PUT-Motorsport/PUTM_EV_REARBOX_2023/hardware/rearbox/rearbox.kicad_pcb

## KiCad design hardware/rearbox/rearbox.kicad_pcb (2026-01-03)

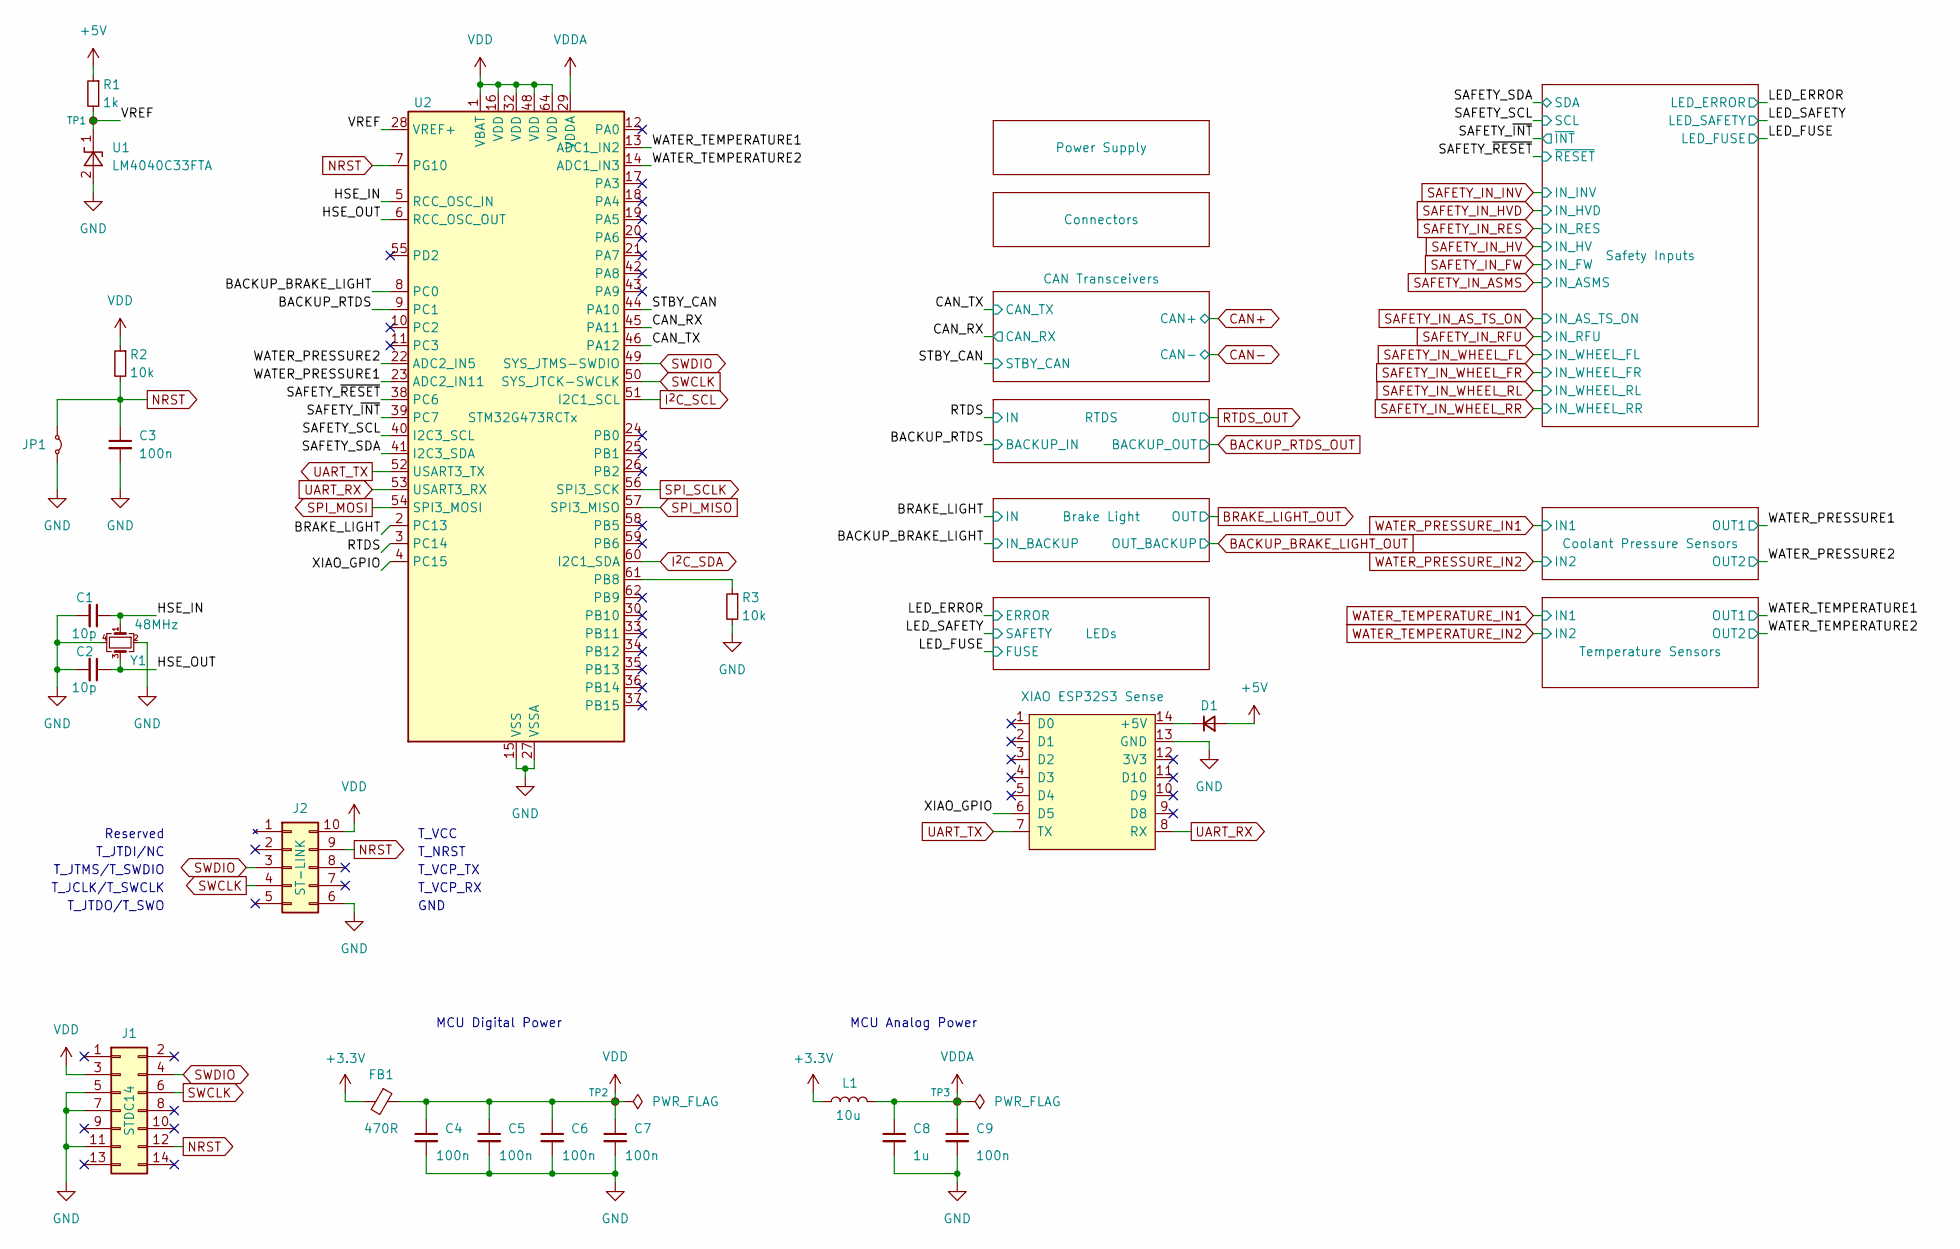
[picture p1: schematic rearbox.kicad_sch]

Parts:
C1, C2: 10p; C_0603_1608Metric
C3, C4, C5, C6, C7, C9: 100n; C_0603_1608Metric
C8: 1u; C_0603_1608Metric
D1: NSVRB751V40T1G; D_SOD-323_HandSoldering; Mouser Part Number 863-NSVRB751V40T1G
FB1: 470R; L_0603_1608Metric
J1: STDC14; PinHeader_2x07_P1.27mm_Vertical_SMD
J2: ST-LINK; STLINK-V3MINIE
J5: XIAO ESP32S3 Sense; XIAO-ESP32S3-DIP
JP1: Jumper_2_Small_Bridged; SolderJumper-2_P1.3mm_Open_TrianglePad1.0x1.5mm
L1: 10u; L_0603_1608Metric
R1: 1k; R_0603_1608Metric
R2, R3: 10k; R_0603_1608Metric
TP1, TP2, TP3: TestPoint_Small; TestPoint_Pad_D1.0mm
U1: LM4040C33FTA; SOT-23
U2: STM32G473RCTx; LQFP-64_10x10mm_P0.5mm
Y1: 48MHz; Crystal_SMD_Abracon_ABM8G-4Pin_3.2x2.5mm

Connections:
+3.3V: FB1.2, L1.1; also elsewhere on the board
+5V: D1.2 (A), R1.1; also elsewhere on the board
/BACKUP_BRAKE_LIGHT: U2.8 (PC0); also elsewhere on the board
/BACKUP_RTDS: U2.9 (PC1); also elsewhere on the board
/BRAKE_LIGHT: U2.2 (PC13); also elsewhere on the board
/CAN_RX: U2.45 (PA11); also elsewhere on the board
/CAN_TX: U2.46 (PA12); also elsewhere on the board
/HSE_IN: C1.1, U2.5 (RCC_OSC_IN), Y1.1
/HSE_OUT: C2.1, U2.6 (RCC_OSC_OUT), Y1.3
/RTDS: U2.3 (PC14); also elsewhere on the board
/SAFETY_SCL: U2.40 (I2C3_SCL); also elsewhere on the board
/SAFETY_SDA: U2.41 (I2C3_SDA); also elsewhere on the board
/SAFETY_~INT: U2.39 (PC7); also elsewhere on the board
/SAFETY_~RESET: U2.38 (PC6); also elsewhere on the board
/STBY_CAN: U2.44 (PA10); also elsewhere on the board
/VREF: R1.2, TP1.1, U1.1 (K), U2.28 (VREF+)
/WATER_PRESSURE1: U2.23 (ADC2_IN11); also elsewhere on the board
/WATER_PRESSURE2: U2.22 (ADC2_IN5); also elsewhere on the board
/WATER_TEMPERATURE1: U2.13 (ADC1_IN2); also elsewhere on the board
/WATER_TEMPERATURE2: U2.14 (ADC1_IN3); also elsewhere on the board
/XIAO_GPIO: J5.6 (D5), U2.4 (PC15)
GND: C1.2, C2.2, C3.2, C4.2, C5.2, C6.2, C7.2, C8.2, C9.2, J1.5, J1.7, J1.11, J2.6 (GND), J5.13 (GND), JP1.2 (B), R3.2, U1.2 (A), U2.15 (VSS), U2.27 (VSSA), U2.31 (VSS), U2.47 (VSS), U2.63 (VSS), Y1.2, Y1.4; also elsewhere on the board
I^{2}C_SCL: U2.51 (I2C1_SCL); also elsewhere on the board
I^{2}C_SDA: U2.60 (I2C1_SDA); also elsewhere on the board
NRST: C3.1, J1.12, J2.9 (T_NRST), JP1.1 (A), R2.2, U2.7 (PG10)
unnamed: D1.1 (K), J5.14 (+5V)
unnamed: R3.1, U2.61 (PB8)
SPI_MISO: U2.57 (SPI3_MISO); also elsewhere on the board
SPI_MOSI: U2.54 (SPI3_MOSI); also elsewhere on the board
SPI_SCLK: U2.56 (SPI3_SCK); also elsewhere on the board
SWCLK: J1.6, J2.4 (T_JCLK/T_SWCLK), U2.50 (SYS_JTCK-SWCLK)
SWDIO: J1.4, J2.3 (T_JTMS/T_SWDIO), U2.49 (SYS_JTMS-SWDIO)
UART_RX: J5.8 (RX), U2.53 (USART3_RX); also elsewhere on the board
UART_TX: J5.7 (TX), U2.52 (USART3_TX); also elsewhere on the board
VDD: C4.1, C5.1, C6.1, C7.1, FB1.1, J1.3, J2.10 (T_VCC), R2.1, TP2.1, U2.1 (VBAT), U2.16 (VDD), U2.32 (VDD), U2.48 (VDD), U2.64 (VDD)
VDDA: C8.1, C9.1, L1.2, TP3.1, U2.29 (VDDA)

Notes on the sheet:
T_JCLK/T_SWCLK
T_JTMS/T_SWDIO
MCU Analog Power
T_JTDI/NC
T_VCC
T_JTDO/T_SWO
T_NRST
Reserved
T_VCP_RX
T_VCP_TX
GND
MCU Digital Power

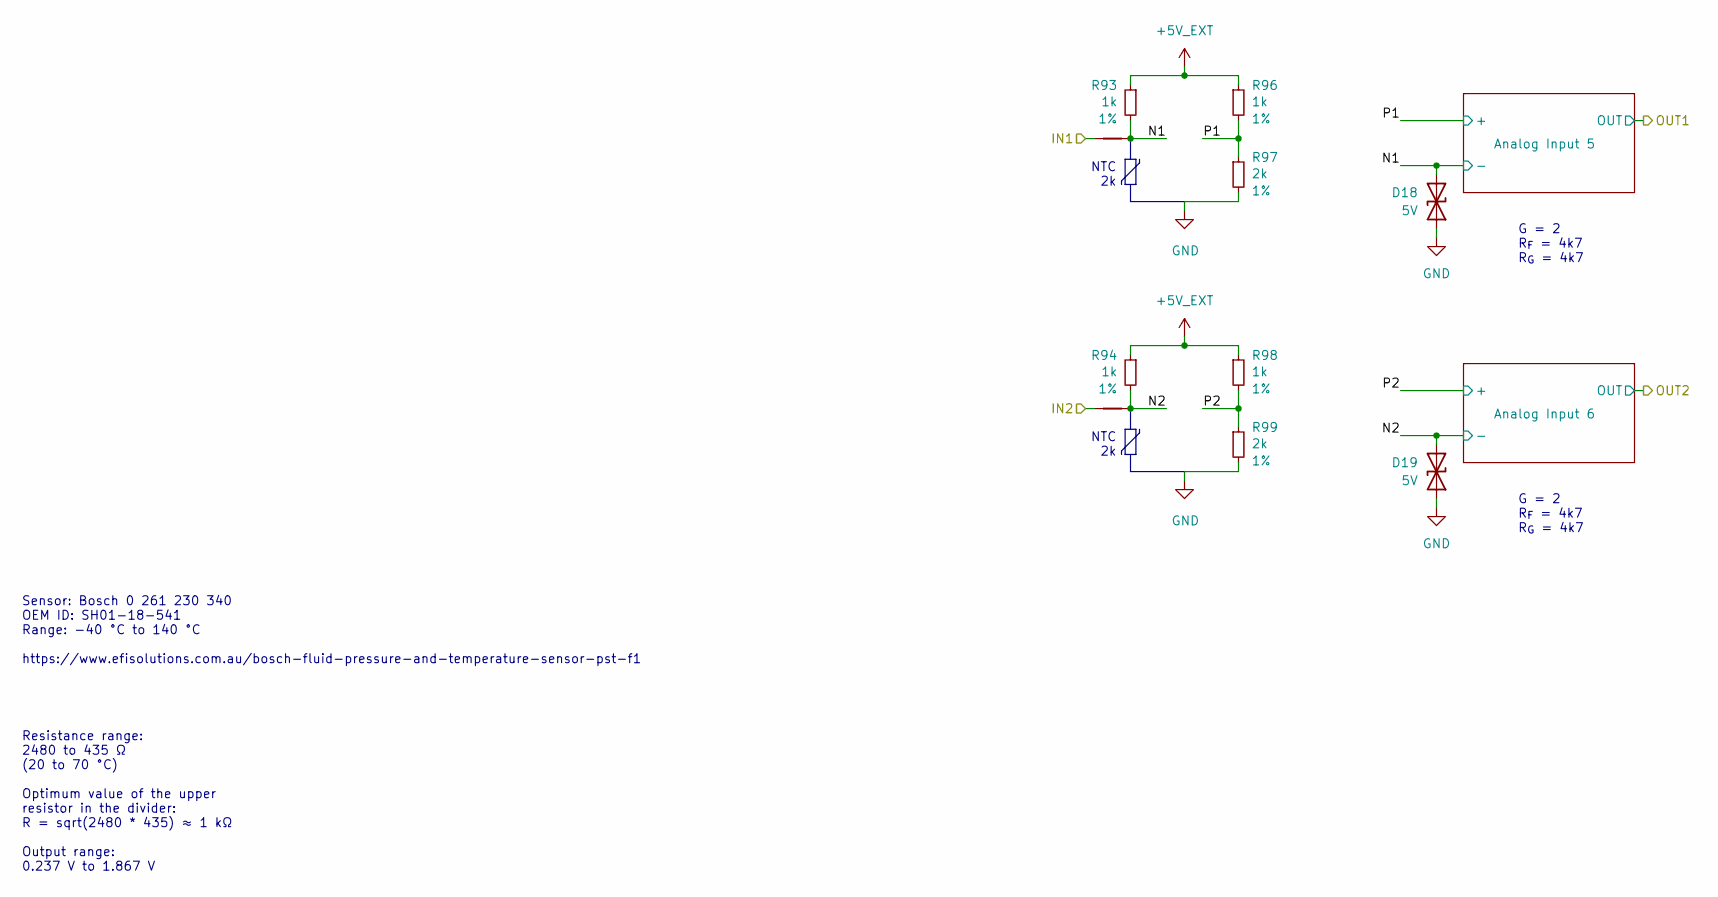
[picture p2: schematic temperature_sensors.kicad_sch, Temperature Sensors]

Parts:
D18, D19: 5V; D_SOD-523
NT1, NT2: NetTie_2; NetTie-2_SMD_Pad0.2mm
R93, R94, R96, R98: 1k; R_0603_1608Metric; Tolerance 1%
R97, R99: 2k; R_0603_1608Metric; Tolerance 1%

Connections:
+5V_EXT: R93.1, R94.1, R96.1, R98.1; also elsewhere on the board
/Temperature Sensors/N1: D18.2 (A2), NT1.2, R93.2; also elsewhere on the board
/Temperature Sensors/N2: D19.2 (A2), NT2.2, R94.2; also elsewhere on the board
/Temperature Sensors/P1: R96.2, R97.1; also elsewhere on the board
/Temperature Sensors/P2: R98.2, R99.1; also elsewhere on the board
GND: D18.1 (A1), D19.1 (A1), R97.2, R99.2; also elsewhere on the board
WATER_TEMPERATURE_IN1: NT1.1; also elsewhere on the board
WATER_TEMPERATURE_IN2: NT2.1; also elsewhere on the board

Notes on the sheet:
G = 2 R_{F} = 4k7 R_{G} = 4k7
NTC 2k
Resistance range: 2480 to 435 Ω (20 to 70 °C) Optimum value of the upper resistor in the divider: R = sqrt(2480 * 435) ≈ 1 kΩ Output range: 0.237 V to 1.867 V
Sensor: Bosch 0 261 230 340 OEM ID: SH01-18-541 Range: -40 °C to 140 °C https://www.efisolutions.com.au/bosch-fluid-pressure-and-temperature-sensor-pst-f1

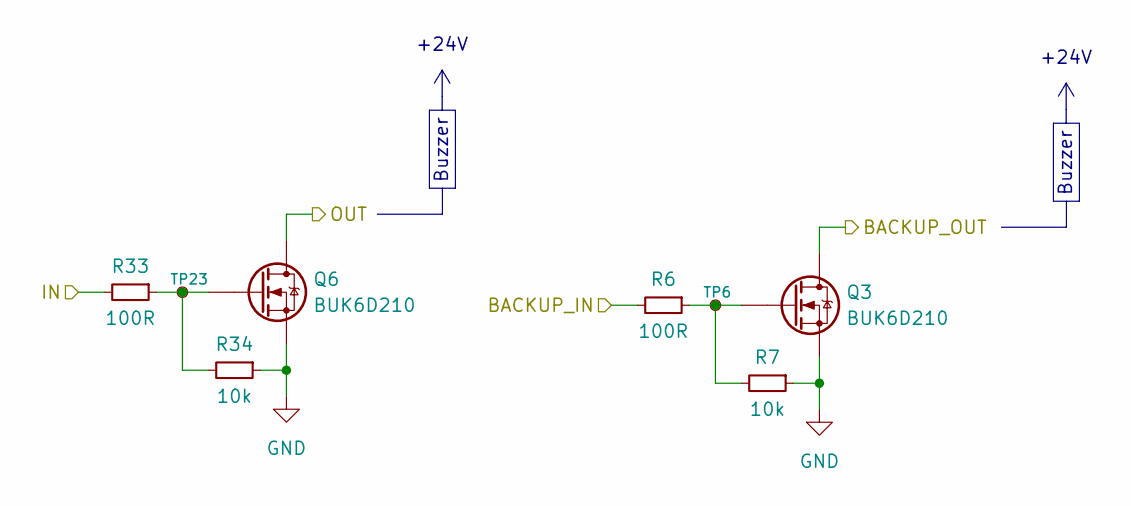
[picture p3: schematic ready_to_drive_sound.kicad_sch, Ready to Drive Sound]

Parts:
Q3, Q6: BUK6D210; Diodes_UDFN2020-6_Type-F
R6, R33: 100R; R_0603_1608Metric
R7, R34: 10k; R_0603_1608Metric
TP6, TP23: TestPoint_Small; TestPoint_Pad_D1.0mm

Connections:
/BACKUP_RTDS: R6.2; also elsewhere on the board
/RTDS: R33.2; also elsewhere on the board
BACKUP_RTDS_OUT: Q3.1 (D), Q3.2 (D), Q3.5 (D), Q3.6 (D), Q3.7 (D); also elsewhere on the board
GND: Q3.4 (S), Q3.8 (S), Q6.4 (S), Q6.8 (S), R7.1, R34.1; also elsewhere on the board
unnamed: Q3.3 (G), R6.1, R7.2, TP6.1
unnamed: Q6.3 (G), R33.1, R34.2, TP23.1
RTDS_OUT: Q6.1 (D), Q6.2 (D), Q6.5 (D), Q6.6 (D), Q6.7 (D); also elsewhere on the board

Notes on the sheet:
+24V
Buzzer

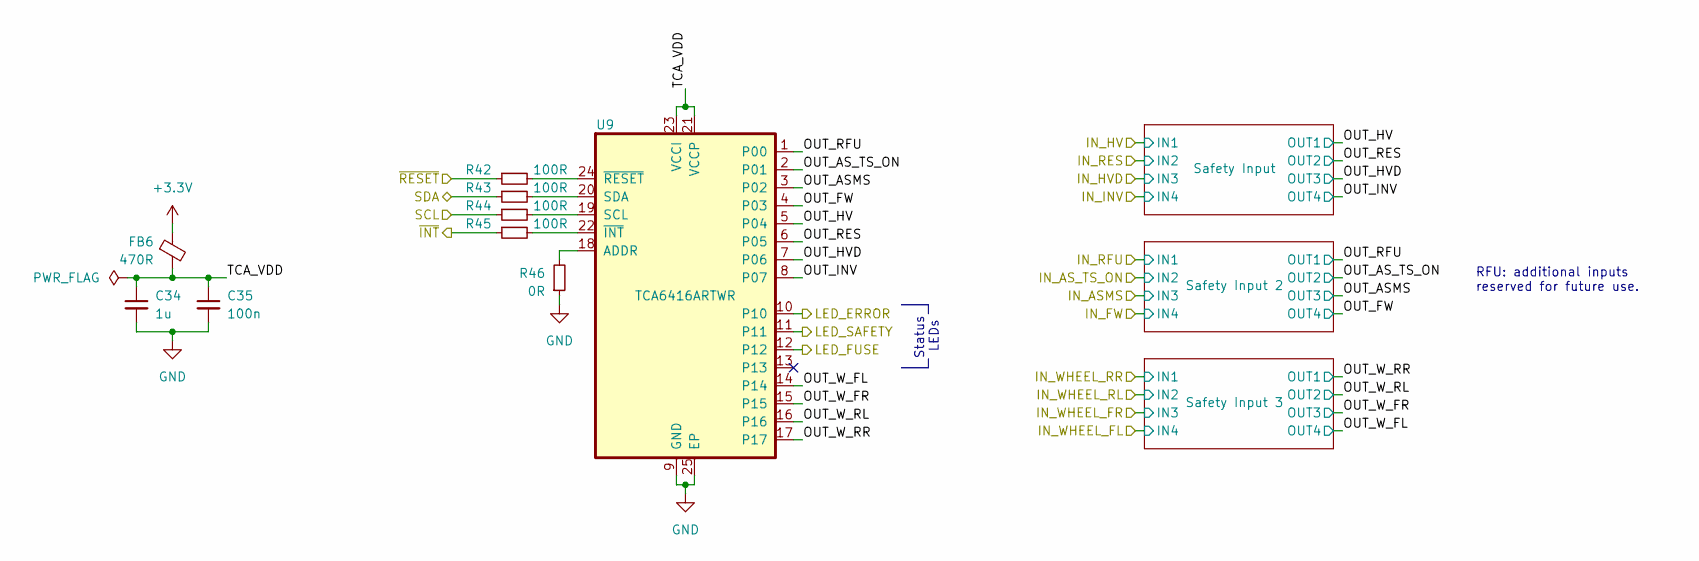
[picture p4: schematic safety_inputs.kicad_sch, Safety Inputs]

Parts:
C34: 1u; C_0603_1608Metric
C35: 100n; C_0603_1608Metric
FB6: 470R; L_0603_1608Metric
R42, R43, R44, R45: 100R; R_0603_1608Metric
R46: 0R; R_0603_1608Metric
U9: TCA6416ARTWR; QFN50P400X400X80-25N

Connections:
+3.3V: FB6.1; also elsewhere on the board
/LED_ERROR: U9.10; also elsewhere on the board
/LED_FUSE: U9.12; also elsewhere on the board
/LED_SAFETY: U9.11; also elsewhere on the board
/SAFETY_SCL: R44.1; also elsewhere on the board
/SAFETY_SDA: R43.1; also elsewhere on the board
/SAFETY_~INT: R45.1; also elsewhere on the board
/SAFETY_~RESET: R42.1; also elsewhere on the board
/Safety Inputs/OUT_ASMS: U9.3 (P02); also elsewhere on the board
/Safety Inputs/OUT_AS_TS_ON: U9.2 (P01); also elsewhere on the board
/Safety Inputs/OUT_FW: U9.4 (P03); also elsewhere on the board
/Safety Inputs/OUT_HV: U9.5 (P04); also elsewhere on the board
/Safety Inputs/OUT_HVD: U9.7 (P06); also elsewhere on the board
/Safety Inputs/OUT_INV: U9.8 (P07); also elsewhere on the board
/Safety Inputs/OUT_RES: U9.6 (P05); also elsewhere on the board
/Safety Inputs/OUT_RFU: U9.1 (P00); also elsewhere on the board
/Safety Inputs/OUT_W_FL: U9.14; also elsewhere on the board
/Safety Inputs/OUT_W_FR: U9.15; also elsewhere on the board
/Safety Inputs/OUT_W_RL: U9.16; also elsewhere on the board
/Safety Inputs/OUT_W_RR: U9.17; also elsewhere on the board
/Safety Inputs/TCA_VDD: C34.1, C35.1, FB6.2, U9.21 (VCCP), U9.23 (VCCI)
GND: C34.2, C35.2, R46.1, U9.9 (GND), U9.25 (EP); also elsewhere on the board
unnamed: R46.2, U9.18 (ADDR)
unnamed: R44.2, U9.19 (SCL)
unnamed: R43.2, U9.20 (SDA)
unnamed: R45.2, U9.22 (~INT)
unnamed: R42.2, U9.24 (~RESET)

Notes on the sheet:
Status LEDs
RFU: additional inputs reserved for future use.

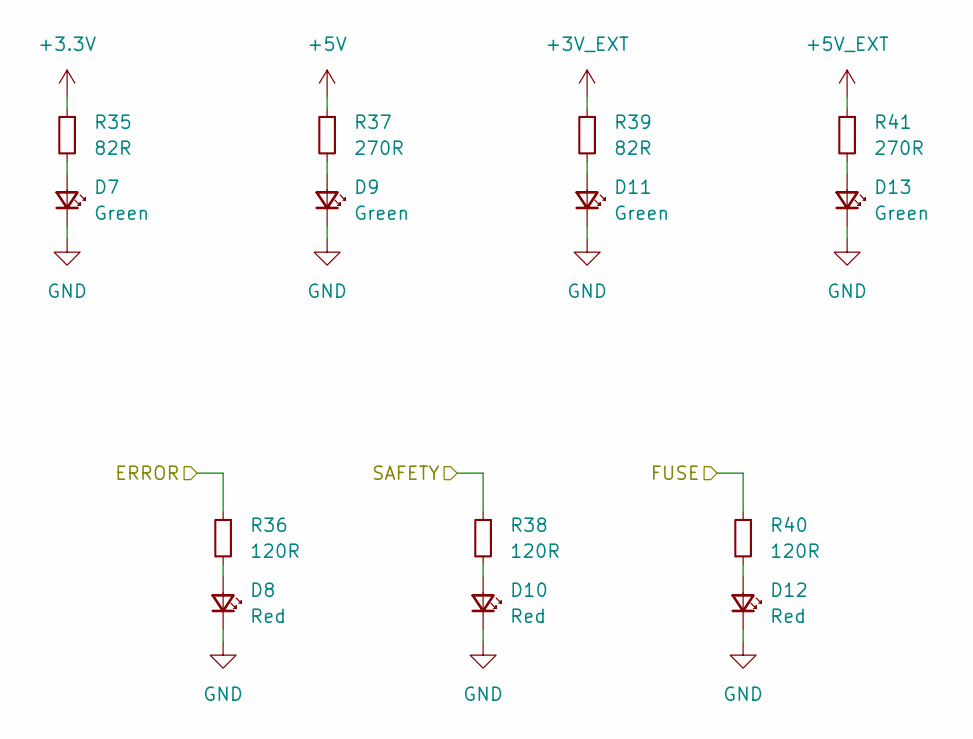
[picture p5: schematic leds.kicad_sch]

Parts:
D7, D9, D11, D13: Green; LED_0603_1608Metric
D8, D10, D12: Red; LED_0603_1608Metric
R35, R39: 82R; R_0603_1608Metric
R36, R38, R40: 120R; R_0603_1608Metric
R37, R41: 270R; R_0603_1608Metric

Connections:
+3.3V: R35.1; also elsewhere on the board
+3V_EXT: R39.1; also elsewhere on the board
+5V: R37.1; also elsewhere on the board
+5V_EXT: R41.1; also elsewhere on the board
/LED_ERROR: R36.1; also elsewhere on the board
/LED_FUSE: R40.1; also elsewhere on the board
/LED_SAFETY: R38.1; also elsewhere on the board
GND: D7.1 (K), D8.1 (K), D9.1 (K), D10.1 (K), D11.1 (K), D12.1 (K), D13.1 (K); also elsewhere on the board
unnamed: D7.2 (A), R35.2
unnamed: D8.2 (A), R36.2
unnamed: D9.2 (A), R37.2
unnamed: D10.2 (A), R38.2
unnamed: D11.2 (A), R39.2
unnamed: D12.2 (A), R40.2
unnamed: D13.2 (A), R41.2

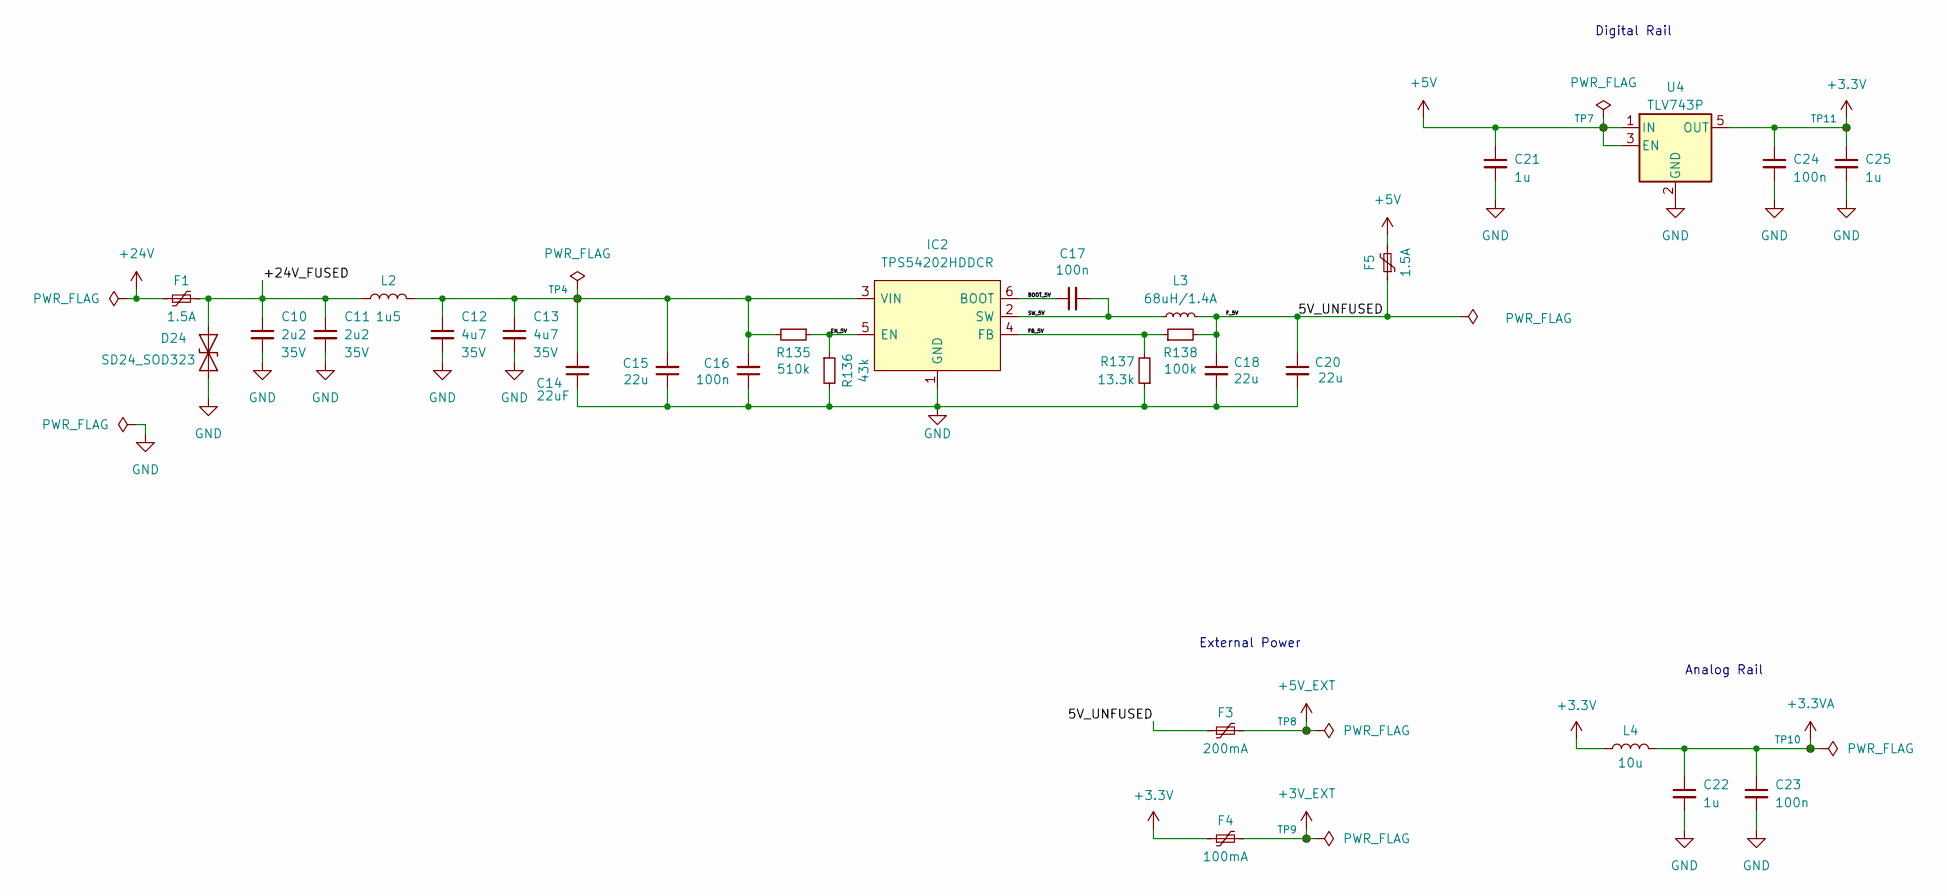
[picture p6: schematic power_supply.kicad_sch, Power Supply]

Parts:
C10, C11: 2u2; C_0805_2012Metric; Rated Voltage 35V
C12, C13: 4u7; C_0805_2012Metric; Rated Voltage 35V
C14: 22uF; C_0805_2012Metric; Manufacturer_Part_Number CL21A107MQYNNWE; Mouser Part Number 810-C2012X5R1V226MAC
C15, C18, C20: 22u; C_0805_2012Metric; Manufacturer_Part_Number CL21A107MQYNNWE; Mouser Part Number 810-C2012X5R1V226MAC
C16, C17: 100n; C_0603_1608Metric; Manufacturer_Part_Number C0603C104J3RACTU; Mouser Part Number --
C21, C22, C25: 1u; C_0603_1608Metric
C23, C24: 100n; C_0603_1608Metric
D24: SD24_SOD323; D_SOD-323
F1, F5: 1.5A; Fuse_1812_4532Metric
F3: 200mA; Fuse_1812_4532Metric
F4: 100mA; Fuse_1812_4532Metric
IC2: TPS54202HDDCR; SOT-23-6; Mouser Part Number 595-TPS54202HDDCR
L2: 1u5; L_Abracon_ASPI-4030S
L3: 68uH/1.4A; L_TDK_VLS6045EX_VLS6045AF; Mouser Part Number 810-VLS6045EX-680M
L4: 10u; L_0603_1608Metric
R135: 510k; R_0603_1608Metric; Manufacturer_Part_Number RT0603DRD07510KL; Mouser Part Number 603-RT0603DRD07510KL
R136: 43k; R_0603_1608Metric; Manufacturer_Part_Number RT0603DRD07510KL; Mouser Part Number 603-RT0603DRD07510KL
R137: 13.3k; R_0603_1608Metric; Manufacturer_Part_Number RT0603DRE0713K3L; Mouser Part Number 603-RT0603DRE0713K3L
R138: 100k; R_0603_1608Metric; Manufacturer_Part_Number RT0603DRE07100KL; Mouser Part Number --
TP4, TP7, TP8, TP9, TP10, TP11: TestPoint_Small; TestPoint_Pad_D1.0mm
U4: TLV743P; SOT-23-5

Connections:
+3.3V: C24.1, C25.1, F4.1, L4.1, TP11.1, U4.5 (OUT); also elsewhere on the board
+3.3VA: C22.1, C23.1, L4.2, TP10.1; also elsewhere on the board
+3V_EXT: F4.2, TP9.1; also elsewhere on the board
+5V: C21.1, F5.2, TP7.1, U4.1 (IN), U4.3 (EN); also elsewhere on the board
+5V_EXT: F3.2, TP8.1; also elsewhere on the board
+24V: F1.1; also elsewhere on the board
/Power Supply/5V_UNFUSED: C18.1, C20.1, F3.1, F5.1, L3.2, R138.2
/Power Supply/+24V_FUSED: C10.1, C11.1, D24.2 (A2), F1.2, L2.1
/Power Supply/BOOT_5V: C17.1, IC2.6 (BOOT)
/Power Supply/EN_5V: IC2.5 (EN), R135.1, R136.1
/Power Supply/FB_5V: IC2.4 (FB), R137.2, R138.1
/Power Supply/SW_5V: C17.2, IC2.2 (SW), L3.1
GND: C10.2, C11.2, C12.2, C13.2, C14.1, C15.1, C16.1, C18.2, C20.2, C21.2, C22.2, C23.2, C24.2, C25.2, D24.1 (A1), IC2.1 (GND), R136.2, R137.1, U4.2 (GND); also elsewhere on the board
unnamed: C12.1, C13.1, C14.2, C15.2, C16.2, IC2.3 (VIN), L2.2, R135.2, TP4.1

Notes on the sheet:
Analog Rail
Digital Rail
External Power

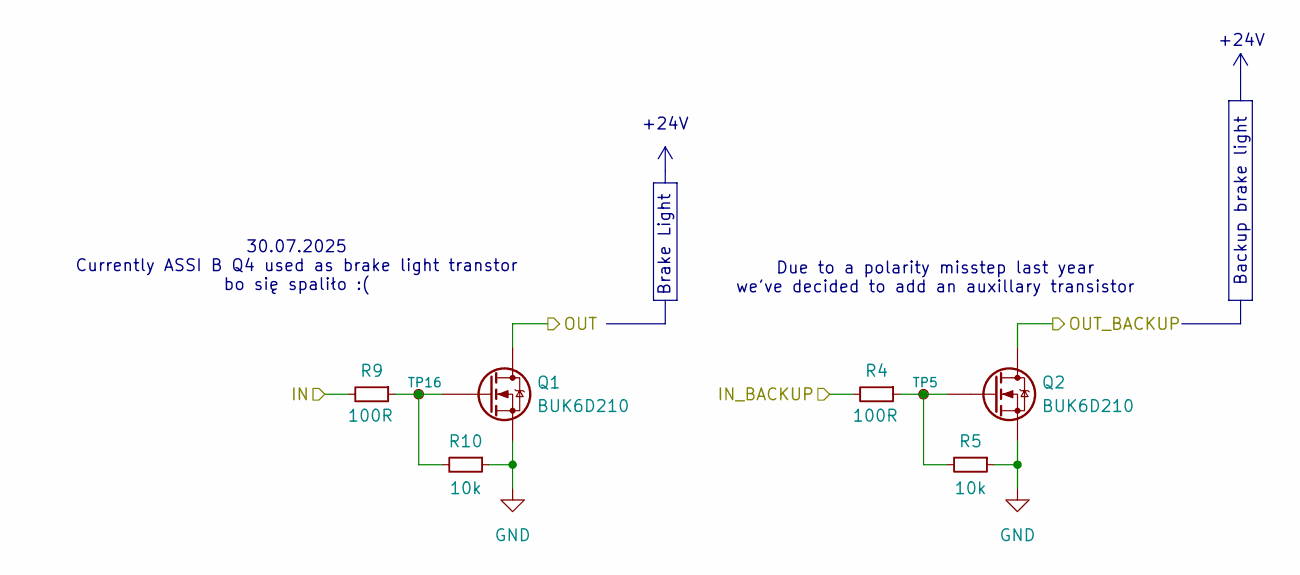
[picture p7: schematic brake_light.kicad_sch, Brake Light]

Parts:
Q1, Q2: BUK6D210; Diodes_UDFN2020-6_Type-F
R4, R9: 100R; R_0603_1608Metric
R5, R10: 10k; R_0603_1608Metric
TP5, TP16: TestPoint_Small; TestPoint_Pad_D1.0mm

Connections:
/BACKUP_BRAKE_LIGHT: R4.2; also elsewhere on the board
/BRAKE_LIGHT: R9.2; also elsewhere on the board
BACKUP_BRAKE_LIGHT_OUT: Q2.1 (D), Q2.2 (D), Q2.5 (D), Q2.6 (D), Q2.7 (D); also elsewhere on the board
BRAKE_LIGHT_OUT: Q1.1 (D), Q1.2 (D), Q1.5 (D), Q1.6 (D), Q1.7 (D); also elsewhere on the board
GND: Q1.4 (S), Q1.8 (S), Q2.4 (S), Q2.8 (S), R5.1, R10.1; also elsewhere on the board
unnamed: Q1.3 (G), R9.1, R10.2, TP16.1
unnamed: Q2.3 (G), R4.1, R5.2, TP5.1

Notes on the sheet:
30.07.2025 Currently ASSI B Q4 used as brake light transtor bo się spaliło :(
Brake Light
+24V
Due to a polarity misstep last year we've decided to add an auxillary transistor
Backup brake light

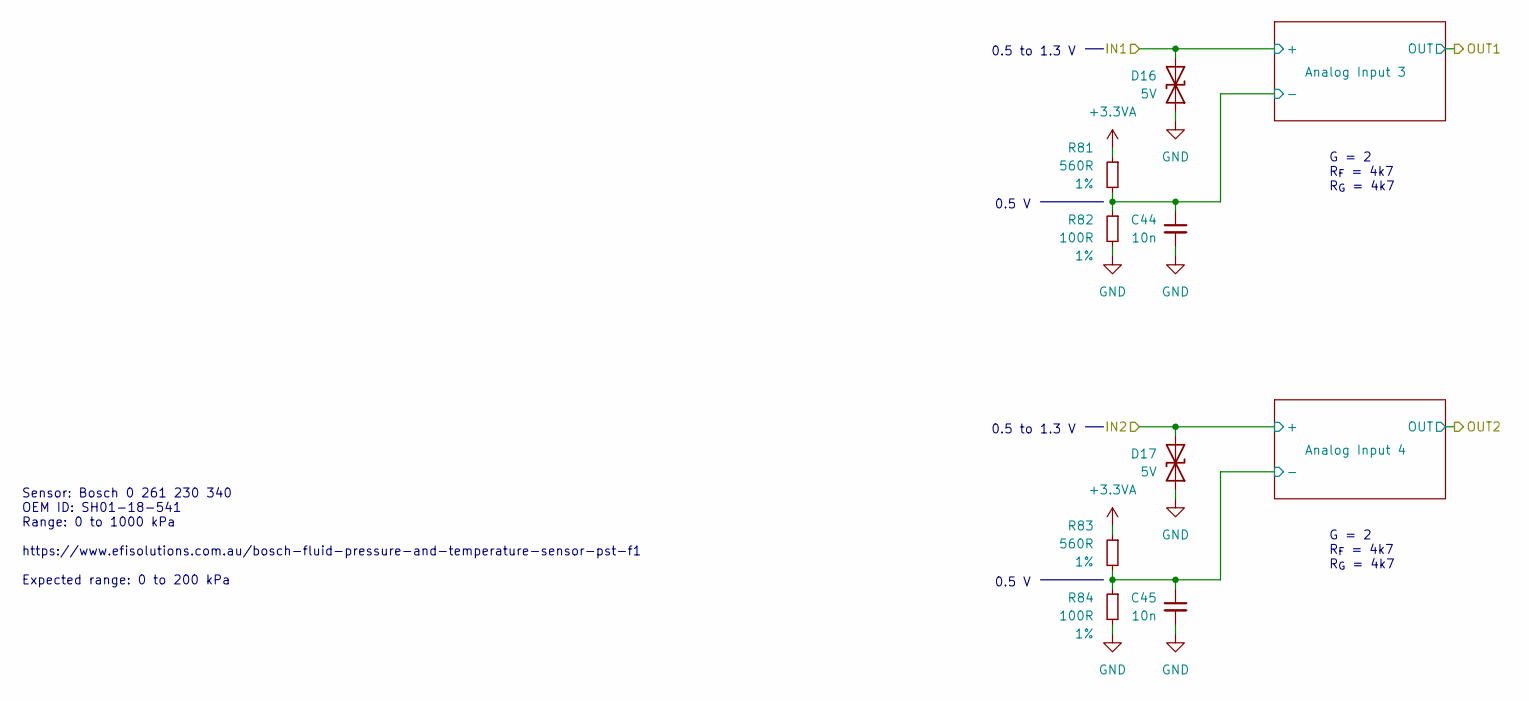
[picture p8: schematic water_pressure_sensors.kicad_sch, Water Pressure Sensors]

Parts:
C44, C45: 10n; C_0603_1608Metric
D16, D17: 5V; D_SOD-523
R81, R83: 560R; R_0603_1608Metric; Tolerance 1%
R82, R84: 100R; R_0603_1608Metric; Tolerance 1%

Connections:
+3.3VA: R81.1, R83.1; also elsewhere on the board
/Coolant Pressure Sensors/Analog Input 3/-: C44.1, R81.2, R82.1; also elsewhere on the board
/Coolant Pressure Sensors/Analog Input 4/-: C45.1, R83.2, R84.1; also elsewhere on the board
GND: C44.2, C45.2, D16.1 (A1), D17.1 (A1), R82.2, R84.2; also elsewhere on the board
WATER_PRESSURE_IN1: D16.2 (A2); also elsewhere on the board
WATER_PRESSURE_IN2: D17.2 (A2); also elsewhere on the board

Notes on the sheet:
0.5 V
0.5 to 1.3 V
G = 2 R_{F} = 4k7 R_{G} = 4k7
Sensor: Bosch 0 261 230 340 OEM ID: SH01-18-541 Range: 0 to 1000 kPa https://www.efisolutions.com.au/bosch-fluid-pressure-and-temperature-sensor-pst-f1 Expected range: 0 to 200 kPa

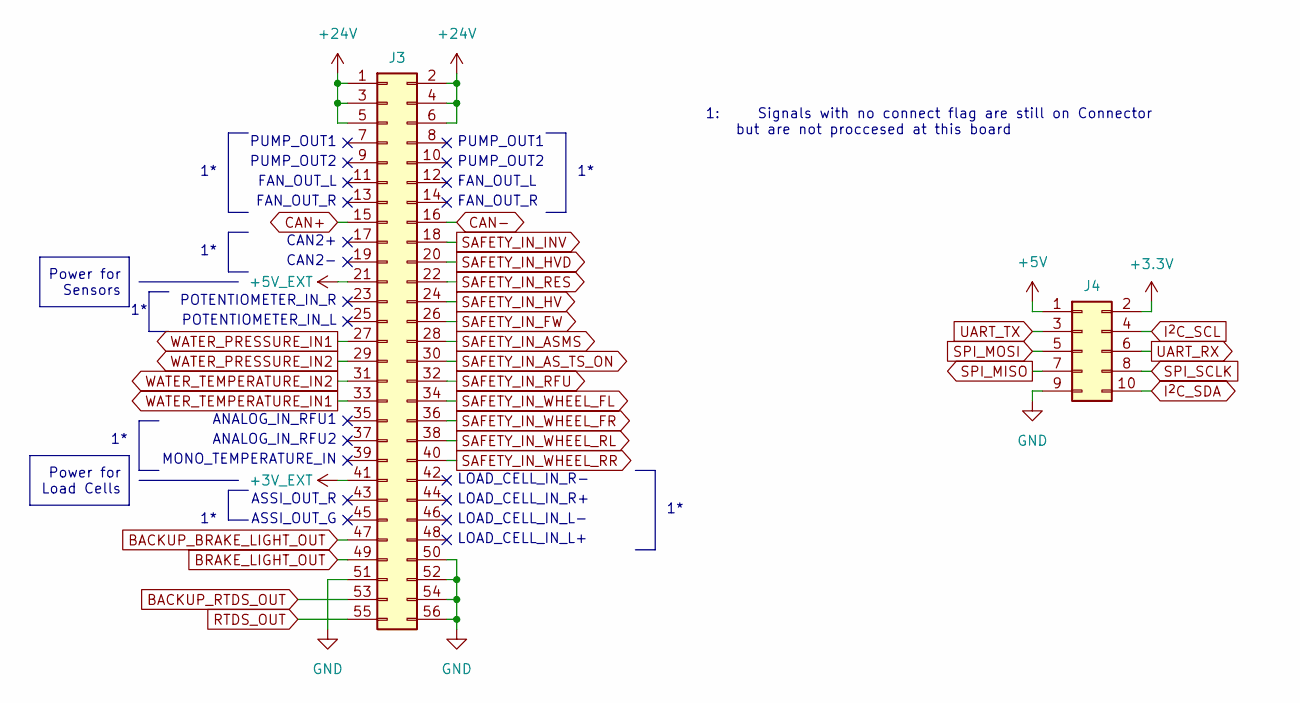
[picture p9: schematic connectors.kicad_sch]

Parts:
J3: Conn_02x28_Top_Bottom; PinHeader_2x28_P2.00mm_Horizontal
J4: Auxiliary; PinHeader_2x05_P1.27mm_Vertical_SMD

Connections:
+3.3V: J4.2; also elsewhere on the board
+3V_EXT: J3.41; also elsewhere on the board
+5V: J4.1; also elsewhere on the board
+5V_EXT: J3.21; also elsewhere on the board
+24V: J3.1, J3.2, J3.3, J3.4, J3.5, J3.6; also elsewhere on the board
BACKUP_BRAKE_LIGHT_OUT: J3.47; also elsewhere on the board
BACKUP_RTDS_OUT: J3.53; also elsewhere on the board
BRAKE_LIGHT_OUT: J3.49; also elsewhere on the board
CAN+: J3.15; also elsewhere on the board
CAN-: J3.16; also elsewhere on the board
GND: J3.50, J3.51, J3.52, J3.54, J3.56, J4.9; also elsewhere on the board
I^{2}C_SCL: J4.4; also elsewhere on the board
I^{2}C_SDA: J4.10; also elsewhere on the board
RTDS_OUT: J3.55; also elsewhere on the board
SAFETY_IN_ASMS: J3.28; also elsewhere on the board
SAFETY_IN_AS_TS_ON: J3.30; also elsewhere on the board
SAFETY_IN_FW: J3.26; also elsewhere on the board
SAFETY_IN_HV: J3.24; also elsewhere on the board
SAFETY_IN_HVD: J3.20; also elsewhere on the board
SAFETY_IN_INV: J3.18; also elsewhere on the board
SAFETY_IN_RES: J3.22; also elsewhere on the board
SAFETY_IN_RFU: J3.32; also elsewhere on the board
SAFETY_IN_WHEEL_FL: J3.34; also elsewhere on the board
SAFETY_IN_WHEEL_FR: J3.36; also elsewhere on the board
SAFETY_IN_WHEEL_RL: J3.38; also elsewhere on the board
SAFETY_IN_WHEEL_RR: J3.40; also elsewhere on the board
SPI_MISO: J4.7; also elsewhere on the board
SPI_MOSI: J4.5; also elsewhere on the board
SPI_SCLK: J4.8; also elsewhere on the board
UART_RX: J4.6; also elsewhere on the board
UART_TX: J4.3; also elsewhere on the board
WATER_PRESSURE_IN1: J3.27; also elsewhere on the board
WATER_PRESSURE_IN2: J3.29; also elsewhere on the board
WATER_TEMPERATURE_IN1: J3.33; also elsewhere on the board
WATER_TEMPERATURE_IN2: J3.31; also elsewhere on the board

Notes on the sheet:
CAN2-
PUMP_OUT2
PUMP_OUT1
ANALOG_IN_RFU2
FAN_OUT_L
LOAD_CELL_IN_R+
ASSI_OUT_G
FAN_OUT_R
POTENTIOMETER_IN_R
ANALOG_IN_RFU1
1: Signals with no connect flag are still on Connector but are not proccesed at this board
POTENTIOMETER_IN_L
LOAD_CELL_IN_L+
LOAD_CELL_IN_R-
ASSI_OUT_R
LOAD_CELL_IN_L-
CAN2+
MONO_TEMPERATURE_IN
Power for Sensors
Power for Load Cells

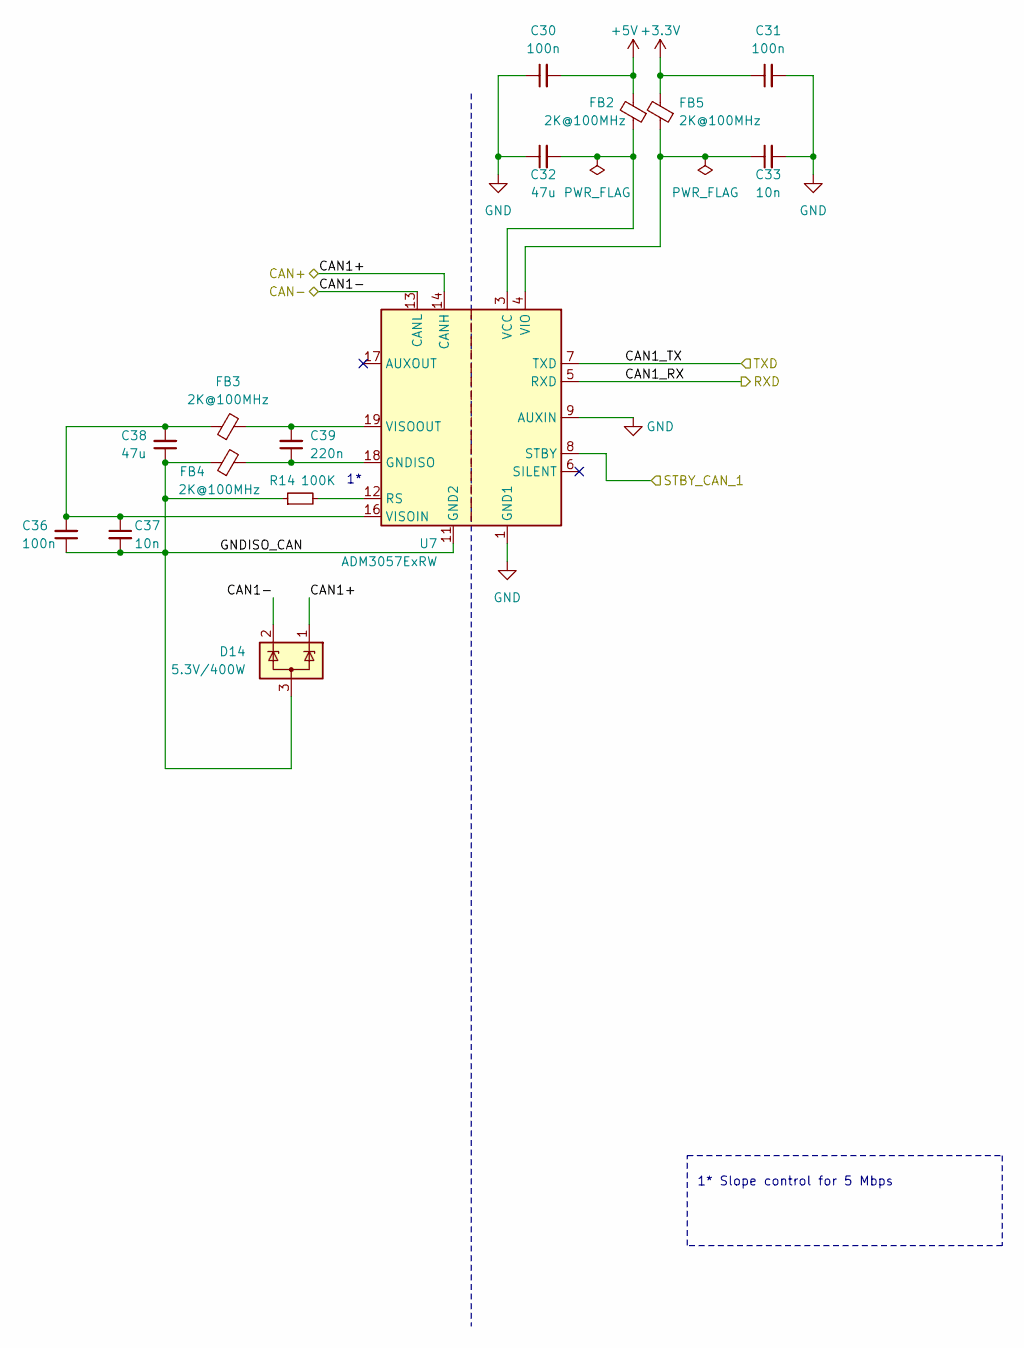
[picture p10: schematic can_transceiver.kicad_sch, CAN Transceiver]

Parts:
C30, C31, C36: 100n; C_0603_1608Metric_Pad1.08x0.95mm_HandSolder
C32, C38: 47u; C_0603_1608Metric_Pad1.08x0.95mm_HandSolder
C33, C37: 10n; C_0603_1608Metric_Pad1.08x0.95mm_HandSolder
C39: 220n; C_0603_1608Metric_Pad1.08x0.95mm_HandSolder
D14: 5.3V/400W; SOT-23-3; Mouser Part Number 511-ESDA5V3L
FB2, FB3, FB4, FB5: 2K@100MHz; L_0805_2012Metric_Pad1.05x1.20mm_HandSolder
R14: 100K; R_0603_1608Metric_Pad0.98x0.95mm_HandSolder
U7: ADM3057ExRW; SOIC-20W_7.5x12.8mm_P1.27mm

Connections:
+3.3V: C31.1, FB5.2; also elsewhere on the board
+5V: C30.2, FB2.2; also elsewhere on the board
/CAN Transceivers/CAN Transceiver/GNDISO_CAN: C36.1, C37.2, C38.1, D14.3 (A), FB4.1, R14.1, U7.11 (GND2), U7.15 (GND2)
/CAN_RX: U7.5 (RXD); also elsewhere on the board
/CAN_TX: U7.7 (TXD); also elsewhere on the board
/STBY_CAN: U7.8 (STBY); also elsewhere on the board
CAN+: D14.1 (K), U7.14 (CANH); also elsewhere on the board
CAN-: D14.2 (K), U7.13 (CANL); also elsewhere on the board
GND: C30.1, C31.2, C32.1, C33.2, U7.1 (GND1), U7.2 (GND1), U7.9 (AUXIN), U7.10 (GND1); also elsewhere on the board
unnamed: C39.1, FB4.2, U7.18 (GNDISO), U7.20 (GNDISO)
unnamed: R14.2, U7.12 (RS)
unnamed: C32.2, FB2.1, U7.3 (VCC)
unnamed: C33.1, FB5.1, U7.4 (VIO)
unnamed: C36.2, C37.1, C38.2, FB3.1, U7.16 (VISOIN)
unnamed: C39.2, FB3.2, U7.19 (VISOOUT)

Notes on the sheet:
1* Slope control for 5 Mbps
