PUT-Motorsport/PUTM_EV_REARBOX_2023/hardware/rearbox/rearbox.kicad_pcb

## KiCad design hardware/rearbox/rearbox.kicad_pcb (continued)

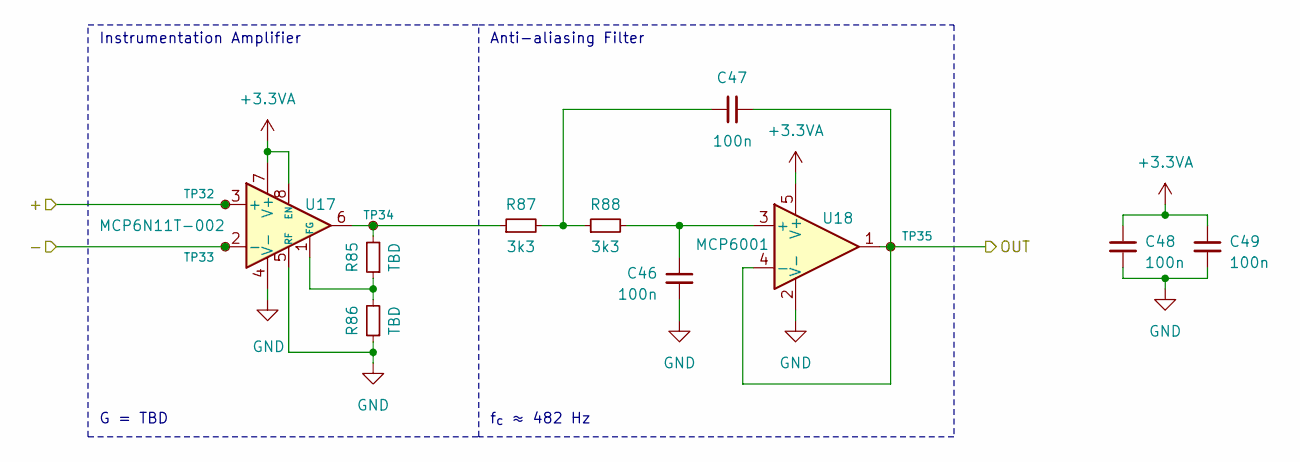
[picture p11: schematic analog_input.kicad_sch, Analog Input]

Parts:
C46, C47, C48, C49: 100n; C_0603_1608Metric
R85, R86: TBD; R_0603_1608Metric
R87, R88: 3k3; R_0603_1608Metric
TP32, TP33, TP34, TP35: TestPoint_Small; TestPoint_Pad_D1.0mm
U17: MCP6N11T-002; TDFN-8-1EP_3x2mm_P0.5mm_EP1.80x1.65mm
U18: MCP6001; SOT-23-5

Connections:
+3.3VA: C48.1, C49.1, U17.7 (V+), U17.8 (EN), U18.5 (V+); also elsewhere on the board
/Coolant Pressure Sensors/Analog Input 3/-: TP33.1, U17.2 (-); also elsewhere on the board
/WATER_PRESSURE1: C47.2, TP35.1, U18.1, U18.4 (-); also elsewhere on the board
GND: C46.2, C48.2, C49.2, R86.1, U17.4 (V-), U17.5 (RF), U17.9 (EP), U18.2 (V-); also elsewhere on the board
unnamed: C47.1, R87.2, R88.1
unnamed: R85.2, R87.1, TP34.1, U17.6
unnamed: R85.1, R86.2, U17.1 (FG)
unnamed: C46.1, R88.2, U18.3 (+)
WATER_PRESSURE_IN1: TP32.1, U17.3 (+); also elsewhere on the board

Parts of its further copies:
C50, C51, C52, C53, C54, C55, C56, C57, C58, C59, C60, C61: 100n; C_0603_1608Metric
R89, R90, R102, R103, R106, R107: TBD; R_0603_1608Metric
R91, R92, R104, R105, R108, R109: 3k3; R_0603_1608Metric
TP36, TP37, TP38, TP39, TP40, TP41, TP42, TP43, TP44, TP45, TP46, TP47: TestPoint_Small; TestPoint_Pad_D1.0mm
U19, U21, U23: MCP6N11T-002; TDFN-8-1EP_3x2mm_P0.5mm_EP1.80x1.65mm
U20, U22, U24: MCP6001; SOT-23-5

Connections of its further copies:
+3.3VA: C52.1, C53.1, C56.1, C57.1, C60.1, C61.1, U19.7 (V+), U19.8 (EN), U20.5 (V+), U21.7 (V+), U21.8 (EN), U22.5 (V+), U23.7 (V+), U23.8 (EN), U24.5 (V+); also elsewhere on the board
/Coolant Pressure Sensors/Analog Input 4/-: TP37.1, U19.2 (-); also elsewhere on the board
/Temperature Sensors/N1: TP41.1, U21.2 (-); also elsewhere on the board
/Temperature Sensors/N2: TP45.1, U23.2 (-); also elsewhere on the board
/Temperature Sensors/P1: TP40.1, U21.3 (+); also elsewhere on the board
/Temperature Sensors/P2: TP44.1, U23.3 (+); also elsewhere on the board
/WATER_PRESSURE2: C51.2, TP39.1, U20.1, U20.4 (-); also elsewhere on the board
/WATER_TEMPERATURE1: C55.2, TP43.1, U22.1, U22.4 (-); also elsewhere on the board
/WATER_TEMPERATURE2: C59.2, TP47.1, U24.1, U24.4 (-); also elsewhere on the board
GND: C50.2, C52.2, C53.2, C54.2, C56.2, C57.2, C58.2, C60.2, C61.2, R90.1, R103.1, R107.1, U19.4 (V-), U19.5 (RF), U19.9 (EP), U20.2 (V-), U21.4 (V-), U21.5 (RF), U21.9 (EP), U22.2 (V-), U23.4 (V-), U23.5 (RF), U23.9 (EP), U24.2 (V-); also elsewhere on the board
unnamed: C51.1, R91.2, R92.1
unnamed: C55.1, R104.2, R105.1
unnamed: C59.1, R108.2, R109.1
unnamed: R89.2, R91.1, TP38.1, U19.6
unnamed: R102.2, R104.1, TP42.1, U21.6
unnamed: R106.2, R108.1, TP46.1, U23.6
unnamed: R89.1, R90.2, U19.1 (FG)
unnamed: C50.1, R92.2, U20.3 (+)
unnamed: R102.1, R103.2, U21.1 (FG)
unnamed: C54.1, R105.2, U22.3 (+)
unnamed: R106.1, R107.2, U23.1 (FG)
unnamed: C58.1, R109.2, U24.3 (+)
WATER_PRESSURE_IN2: TP36.1, U19.3 (+); also elsewhere on the board

Notes on the sheet:
Anti-aliasing Filter
G = TBD
f_{c} ≈ 482 Hz
Instrumentation Amplifier

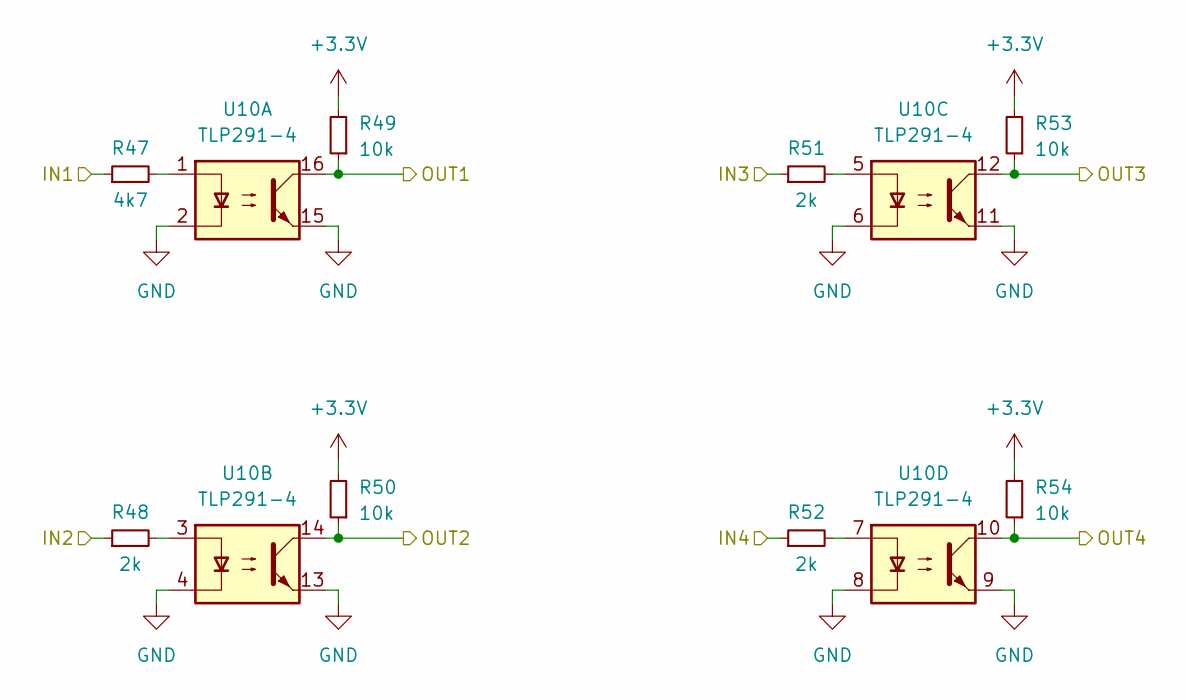
[picture p12: schematic safety_input.kicad_sch, Safety Input]

Parts:
R47: 4k7; R_0603_1608Metric
R48, R51, R52: 2k; R_0603_1608Metric
R49, R50, R53, R54: 10k; R_0603_1608Metric
U10: TLP291-4; SOIC-16_4.55x10.3mm_P1.27mm

Connections:
+3.3V: R49.2, R50.2, R53.2, R54.2; also elsewhere on the board
/Safety Inputs/OUT_HV: R49.1, U10.16; also elsewhere on the board
/Safety Inputs/OUT_HVD: R53.1, U10.12; also elsewhere on the board
/Safety Inputs/OUT_INV: R54.1, U10.10; also elsewhere on the board
/Safety Inputs/OUT_RES: R50.1, U10.14; also elsewhere on the board
GND: U10.2, U10.4, U10.6, U10.8, U10.9, U10.11, U10.13, U10.15; also elsewhere on the board
unnamed: R47.2, U10.1
unnamed: R48.2, U10.3
unnamed: R51.2, U10.5
unnamed: R52.2, U10.7
SAFETY_IN_HV: R47.1; also elsewhere on the board
SAFETY_IN_HVD: R51.1; also elsewhere on the board
SAFETY_IN_INV: R52.1; also elsewhere on the board
SAFETY_IN_RES: R48.1; also elsewhere on the board

Parts of its further copies:
R55, R63: 4k7; R_0603_1608Metric
R56, R59, R60, R64, R67, R68: 2k; R_0603_1608Metric
R57, R58, R61, R62, R65, R66, R69, R70: 10k; R_0603_1608Metric
U11, U12: TLP291-4; SOIC-16_4.55x10.3mm_P1.27mm

Connections of its further copies:
+3.3V: R57.2, R58.2, R61.2, R62.2, R65.2, R66.2, R69.2, R70.2; also elsewhere on the board
/Safety Inputs/OUT_ASMS: R61.1, U11.12; also elsewhere on the board
/Safety Inputs/OUT_AS_TS_ON: R58.1, U11.14; also elsewhere on the board
/Safety Inputs/OUT_FW: R62.1, U11.10; also elsewhere on the board
/Safety Inputs/OUT_RFU: R57.1, U11.16; also elsewhere on the board
/Safety Inputs/OUT_W_FL: R70.1, U12.10; also elsewhere on the board
/Safety Inputs/OUT_W_FR: R69.1, U12.12; also elsewhere on the board
/Safety Inputs/OUT_W_RL: R66.1, U12.14; also elsewhere on the board
/Safety Inputs/OUT_W_RR: R65.1, U12.16; also elsewhere on the board
GND: U11.2, U11.4, U11.6, U11.8, U11.9, U11.11, U11.13, U11.15, U12.2, U12.4, U12.6, U12.8, U12.9, U12.11, U12.13, U12.15; also elsewhere on the board
unnamed: R55.2, U11.1
unnamed: R56.2, U11.3
unnamed: R59.2, U11.5
unnamed: R60.2, U11.7
unnamed: R63.2, U12.1
unnamed: R64.2, U12.3
unnamed: R67.2, U12.5
unnamed: R68.2, U12.7
SAFETY_IN_ASMS: R59.1; also elsewhere on the board
SAFETY_IN_AS_TS_ON: R56.1; also elsewhere on the board
SAFETY_IN_FW: R60.1; also elsewhere on the board
SAFETY_IN_RFU: R55.1; also elsewhere on the board
SAFETY_IN_WHEEL_FL: R68.1; also elsewhere on the board
SAFETY_IN_WHEEL_FR: R67.1; also elsewhere on the board
SAFETY_IN_WHEEL_RL: R64.1; also elsewhere on the board
SAFETY_IN_WHEEL_RR: R63.1; also elsewhere on the board

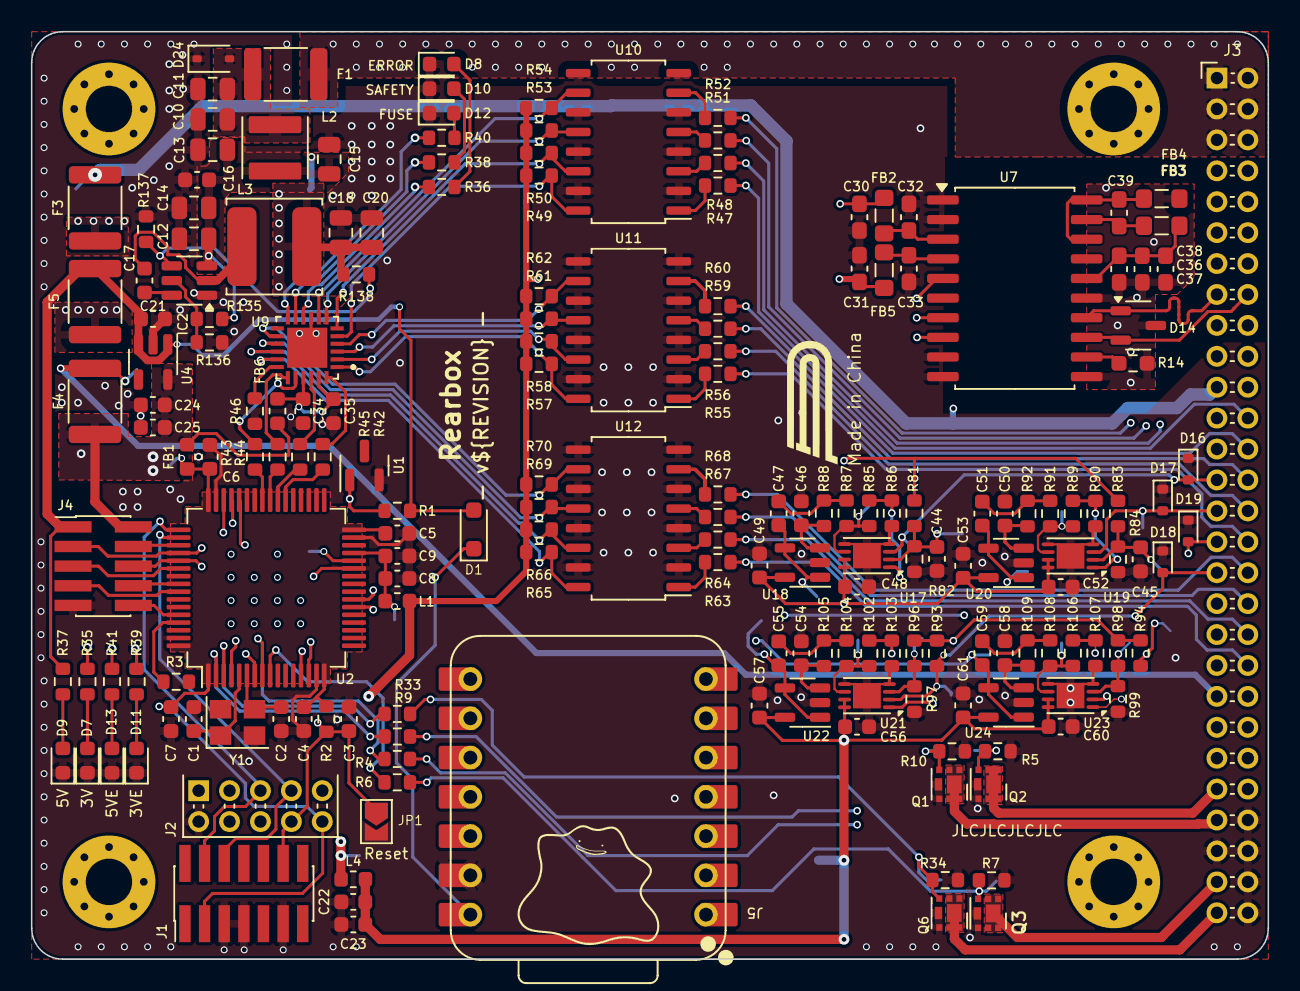
[picture p13: board rearbox.kicad_pcb from above]

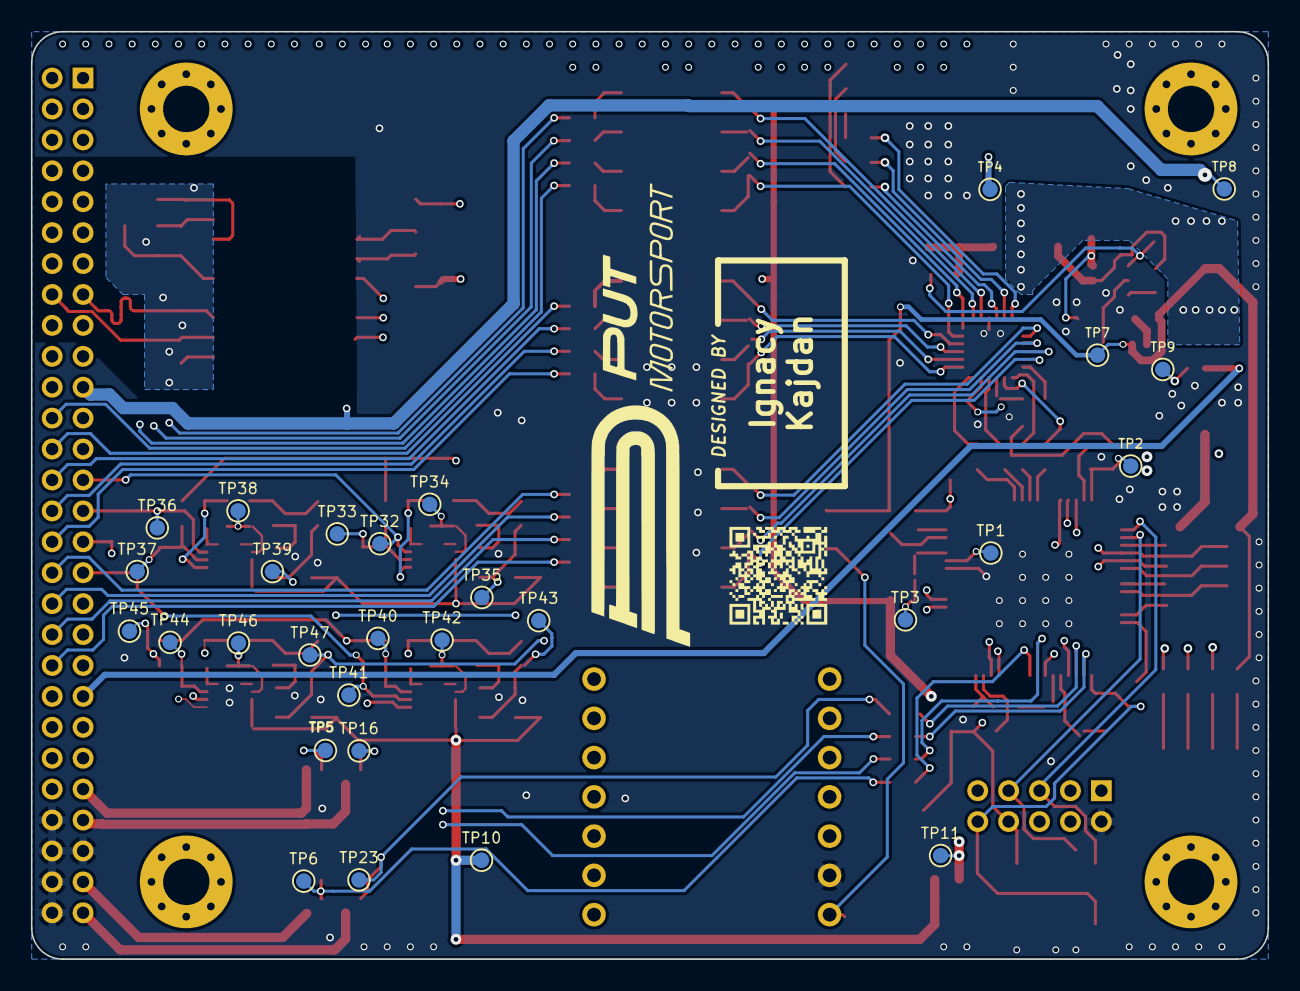
[picture p14: board rearbox.kicad_pcb from below]

Board: 4 copper layers, 80.0 x 60.0 mm, 217 parts (29 on the bottom side), 142 nets.
