PUT-Motorsport/PUTM_EV_REARBOX_2023/firmware/firmware.ioc

Mcu.UserName=STM32G473RCTx
PA1.GPIO_Label=WATER_TEMPERATURE1
PA1.Signal=ADC1_IN2
PA10.GPIO_Label=STBY_CAN
PA10.Signal=GPXTI10
PA11.GPIO_Label=CAN_RX
PA11.Signal=FDCAN1_RX
PA12.GPIO_Label=CAN_TX
PA12.Signal=FDCAN1_TX
PA13.GPIO_Label=SWDIO
PA13.Signal=SYS_JTMS-SWDIO
PA14.GPIO_Label=SWCLK
PA14.Signal=SYS_JTCK-SWCLK
PA15.GPIO_Label=I2C_SCL
PA15.Signal=I2C1_SCL
PA2.GPIO_Label=WATER_TEMPERATURE2
PA2.Signal=ADC1_IN3
PA4.GPIO_Label=ANALOG_OFFSET1
PA4.Signal=COMP_DAC11_group
PA5.GPIO_Label=ANALOG_OFFSET2
PA5.Signal=COMP_DAC12_group
PB3.GPIO_Label=SPI_SCLK
PB3.Signal=SPI3_SCK
PB4.GPIO_Label=SPI_MISO
PB4.Signal=SPI3_MISO
PB7.GPIO_Label=I2C_SDA
PB7.Signal=I2C1_SDA
PB8-BOOT0.GPIO_Label=BOOT_SELECT
PB8-BOOT0.Signal=GPIO_Output
PC0.GPIO_Label=BRAKE_LIGHT
PC0.Signal=GPIO_Output
PC1.GPIO_Label=BACKUP_RTDS
PC1.Signal=GPIO_Output
PC10.GPIO_Label=UART_TX
PC10.Signal=USART3_TX
PC11.GPIO_Label=UART_RX
PC11.Signal=USART3_RX
PC12.GPIO_Label=SPI_MOSI
PC12.Signal=SPI3_MOSI
PC13.GPIO_Label=BACKUP_BRAKE_LIGHT
PC13.Signal=GPIO_Output
PC14-OSC32_IN.GPIO_Label=RTDS
PC14-OSC32_IN.Signal=GPIO_Output
PC15-OSC32_OUT.GPIO_Label=XIAO_GPIO
PC15-OSC32_OUT.Signal=GPIO_Output
PC4.GPIO_Label=WATER_PRESSURE2
PC4.Signal=ADC2_IN5
PC5.GPIO_Label=WATER_PRESSURE1
PC5.Signal=ADC2_IN11
PC6.GPIO_Label=SAFETY_RESET
PC6.Signal=GPIO_Output
PC7.GPIO_Label=SAFETY_INT
PC7.Signal=GPXTI7
PC8.GPIO_Label=SAFETY_SCL
PC8.Signal=I2C3_SCL
PC9.GPIO_Label=SAFETY_SDA
PC9.Signal=I2C3_SDA
PF0-OSC_IN.GPIO_Label=HSE_IN
PF0-OSC_IN.Signal=RCC_OSC_IN
PF1-OSC_OUT.GPIO_Label=HSE_OUT
PF1-OSC_OUT.Signal=RCC_OSC_OUT
