PUT-Motorsport/PUTM_EV_REARBOX_2023/firmware/Core/Inc/main.h

#define BACKUP_BRAKE_LIGHT_Pin GPIO_PIN_13
#define BACKUP_BRAKE_LIGHT_GPIO_Port GPIOC
#define RTDS_Pin GPIO_PIN_14
#define RTDS_GPIO_Port GPIOC
#define XIAO_GPIO_Pin GPIO_PIN_15
#define XIAO_GPIO_GPIO_Port GPIOC
#define HSE_IN_Pin GPIO_PIN_0
#define HSE_IN_GPIO_Port GPIOF
#define HSE_OUT_Pin GPIO_PIN_1
#define HSE_OUT_GPIO_Port GPIOF
#define BRAKE_LIGHT_Pin GPIO_PIN_0
#define BRAKE_LIGHT_GPIO_Port GPIOC
#define BACKUP_RTDS_Pin GPIO_PIN_1
#define BACKUP_RTDS_GPIO_Port GPIOC
#define WATER_TEMPERATURE1_Pin GPIO_PIN_1
#define WATER_TEMPERATURE1_GPIO_Port GPIOA
#define WATER_TEMPERATURE2_Pin GPIO_PIN_2
#define WATER_TEMPERATURE2_GPIO_Port GPIOA
#define ANALOG_OFFSET1_Pin GPIO_PIN_4
#define ANALOG_OFFSET1_GPIO_Port GPIOA
#define ANALOG_OFFSET2_Pin GPIO_PIN_5
#define ANALOG_OFFSET2_GPIO_Port GPIOA
#define WATER_PRESSURE2_Pin GPIO_PIN_4
#define WATER_PRESSURE2_GPIO_Port GPIOC
#define WATER_PRESSURE1_Pin GPIO_PIN_5
#define WATER_PRESSURE1_GPIO_Port GPIOC
#define SAFETY_RESET_Pin GPIO_PIN_6
#define SAFETY_RESET_GPIO_Port GPIOC
#define SAFETY_INT_Pin GPIO_PIN_7
#define SAFETY_INT_GPIO_Port GPIOC
#define SAFETY_SCL_Pin GPIO_PIN_8
#define SAFETY_SCL_GPIO_Port GPIOC
#define SAFETY_SDA_Pin GPIO_PIN_9
#define SAFETY_SDA_GPIO_Port GPIOC
#define STBY_CAN_Pin GPIO_PIN_10
#define STBY_CAN_GPIO_Port GPIOA
#define CAN_RX_Pin GPIO_PIN_11
#define CAN_RX_GPIO_Port GPIOA
#define CAN_TX_Pin GPIO_PIN_12
#define CAN_TX_GPIO_Port GPIOA
#define SWDIO_Pin GPIO_PIN_13
#define SWDIO_GPIO_Port GPIOA
#define SWCLK_Pin GPIO_PIN_14
#define SWCLK_GPIO_Port GPIOA
#define I2C_SCL_Pin GPIO_PIN_15
#define I2C_SCL_GPIO_Port GPIOA
#define UART_TX_Pin GPIO_PIN_10
#define UART_TX_GPIO_Port GPIOC
#define UART_RX_Pin GPIO_PIN_11
#define UART_RX_GPIO_Port GPIOC
#define SPI_MOSI_Pin GPIO_PIN_12
#define SPI_MOSI_GPIO_Port GPIOC
#define SPI_SCLK_Pin GPIO_PIN_3
#define SPI_SCLK_GPIO_Port GPIOB
#define SPI_MISO_Pin GPIO_PIN_4
#define SPI_MISO_GPIO_Port GPIOB
#define I2C_SDA_Pin GPIO_PIN_7
#define I2C_SDA_GPIO_Port GPIOB
#define BOOT_SELECT_Pin GPIO_PIN_8
#define BOOT_SELECT_GPIO_Port GPIOB
#define ADC_CHANNEL_MONO_TEMPERATURE 0
#define ADC_CHANNEL_COOLANT_IN_PRESSURE 4
#define ADC_CHANNEL_COOLANT_OUT_PRESSURE 5
#define ADC_CHANNEL_COOLANT_IN_TEMPERATURE 2
#define ADC_CHANNEL_COOLANT_OUT_TEMPERATURE 3
#define ADC_CHANNEL_OIL_L_TEMPERATURE 0
#define ADC_CHANNEL_OIL_R_TEMPERATURE 1
#define ADC_CHANNEL_SUSPENSION_POTENTIOMETER_L 2
#define ADC_CHANNEL_SUSPENSION_POTENTIOMETER_R 3
#define PIN_ERROR_LED 8
#define PIN_SAFETY_LED 9
#define PIN_FUSE_LED 10
#define PIN_RFU2 0
#define PIN_RFU1 1
#define PIN_ASMS 2
#define PIN_FW 3
#define PIN_HV 4
#define PIN_RES 5
#define PIN_HVD 6
#define PIN_INV 7
#define PIN_WHEEL_FL 12
#define PIN_WHEEL_FR 13
#define PIN_WHEEL_RL 14
#define PIN_WHEEL_RR 15
#define LOG_LEVEL 2
