PUT-Motorsport/PUTM_EV_REARBOX_2023/firmware/Tasks/Inc/communication_task.h

/**
 ******************************************************************************
 * @file           : communication_task.h
 * @brief          : CAN communication task
 *
 ******************************************************************************
 */

#ifndef __COMMUNICATION_TASK_H__
#define __COMMUNICATION_TASK_H__

/* Public includes -----------------------------------------------------------*/
#ifdef __cplusplus
extern "C" {
#endif

void Communication_Task(void* argument);

#ifdef __cplusplus
}
#endif

/* Public typedefs -----------------------------------------------------------*/

/* Public defines ------------------------------------------------------------*/

/* Public macros -------------------------------------------------------------*/

/* Public variables ----------------------------------------------------------*/

/* Public function prototypes ------------------------------------------------*/

#endif /* __COMMUNICATION_TASK_H__ */
