PUT-Motorsport/PUTM_EV_REARBOX_2023/firmware/Tasks/Inc/safety_task.h

/**
 ******************************************************************************
 * @file           : safety_task.h
 * @brief          : Safety senses readout task
 *
 ******************************************************************************
 */

#ifndef __SAFETY_TASK_H__
#define __SAFETY_TASK_H__

/* Public includes -----------------------------------------------------------*/
#ifdef __cplusplus
extern "C" {
#endif

void Safety_Task(void* argument);

#ifdef __cplusplus
}
#endif

/* Public typedefs -----------------------------------------------------------*/

/* Public defines ------------------------------------------------------------*/

/* Public macros -------------------------------------------------------------*/

/* Public variables ----------------------------------------------------------*/

/* Public function prototypes ------------------------------------------------*/

#endif /* __SAFETY_TASK_H__ */
