PUT-Motorsport/PUTM_EV_REARBOX_2023/firmware/Tasks/Inc/led_test_task.h

/**
 ******************************************************************************
 * @file           : led_test_task.h
 * @brief          : LED test task
 *
 ******************************************************************************
 */

#ifndef __LED_TEST_TASK_H__
#define __LED_TEST_TASK_H__

/* Public includes -----------------------------------------------------------*/
#ifdef __cplusplus
extern "C" {
#endif

void Led_Test_Task(void* argument);

#ifdef __cplusplus
}
#endif

/* Public typedefs -----------------------------------------------------------*/

/* Public defines ------------------------------------------------------------*/

/* Public macros -------------------------------------------------------------*/

/* Public variables ----------------------------------------------------------*/

/* Public function prototypes ------------------------------------------------*/

#endif /* __LED_TEST_TASK_H__ */
