PUT-Motorsport/PUTM_EV_REARBOX_2023/(commit log)

2025-04-17 Changed power section
    [analog_input.kicad_sch, analog_inputs.kicad_sch, assi.kicad_sch, brake_light.kicad_sch, can_transceiver.kicad_sch, can_transceivers.kicad_sch, connectors.kicad_sch, fused_output.kicad_sch]
2025-04-23 Added ESD protection to power section
    [analog_inputs.kicad_sch, power_supply.kicad_sch, rearbox.kicad_pcb, temperature_sensors.kicad_sch, water_pressure_sensors.kicad_sch]
2025-04-24 Changed text layout on PCB
    [rearbox.kicad_pcb]
2025-08-04 Sync :(
    [analog_inputs.kicad_sch, assi.kicad_sch, brake_light.kicad_sch, connector.kicad_sch, power_supply.kicad_sch, temperature_sensors.kicad_sch, water_pressure_sensors.kicad_sch]
2025-10-28 Deleted measurement systems for new iteration
    [analog_input.kicad_sch, can_transceiver.kicad_sch, can_transceivers.kicad_sch, connectors.kicad_sch, rearbox.kicad_pcb, rearbox.kicad_sch, temperature_sensors.kicad_sch, water_pressure_sensors.kicad_sch]
2025-10-28 Positioned new CANBUS components on PCB
    [rearbox.kicad_pcb]
2025-10-29 Fixed problematic silkscreen placements
    [rearbox.kicad_pcb]
2025-11-04 Moved the CAN IC to a less retarded position
    [rearbox.kicad_pcb]
2025-11-04 Oops! all bad ISOGND zones!
    [rearbox.kicad_pcb]
2025-11-04 Better routing of 5V_EXT and safety lines made to minimise CAN noise
    [rearbox.kicad_pcb]
2025-11-04 Fixed badly thought out CAN GND
    [can_transceiver.kicad_sch, rearbox.kicad_pcb]
2025-11-11 Moved CAN IC to shorten CAN traces length and shortened isognd lengths
    [rearbox.kicad_pcb]
2025-11-11 Fixed one small detail that piotrus found
    [rearbox.kicad_pcb]
2025-11-13 Added an auxillary transistor for rear brakelights in case they burn up again and fixed some GNDISO_CAN problems
    [brake_light.kicad_sch, connectors.kicad_sch, rearbox.kicad_pcb, rearbox.kicad_sch]
2025-11-13 Removed a leftover fill zone
    [rearbox.kicad_pcb]
2025-11-13 Fixed an oopsie with a zone fill
    [rearbox.kicad_pcb]
2025-11-18 Added an auxillary RTDS transistor as a backup
    [connectors.kicad_sch, ready_to_drive_sound.kicad_sch, rearbox.kicad_pcb, rearbox.kicad_sch]
2025-12-02 Made ferrites into 0805's
    [can_transceiver.kicad_sch, rearbox.kicad_pcb]
2026-01-03 Fixed bad silkscreen placement
    [rearbox.kicad_pcb]
2026-07-01 Updated DBCs and partially fixed CAN comms
    [firmware.ioc]
